adafruit/Adafruit-I2S-Amplifier-BFF-PCB/Adafruit I2S Amplifier BFF.brd

## EAGLE design Adafruit I2S Amplifier BFF.brd (2023-06-14)

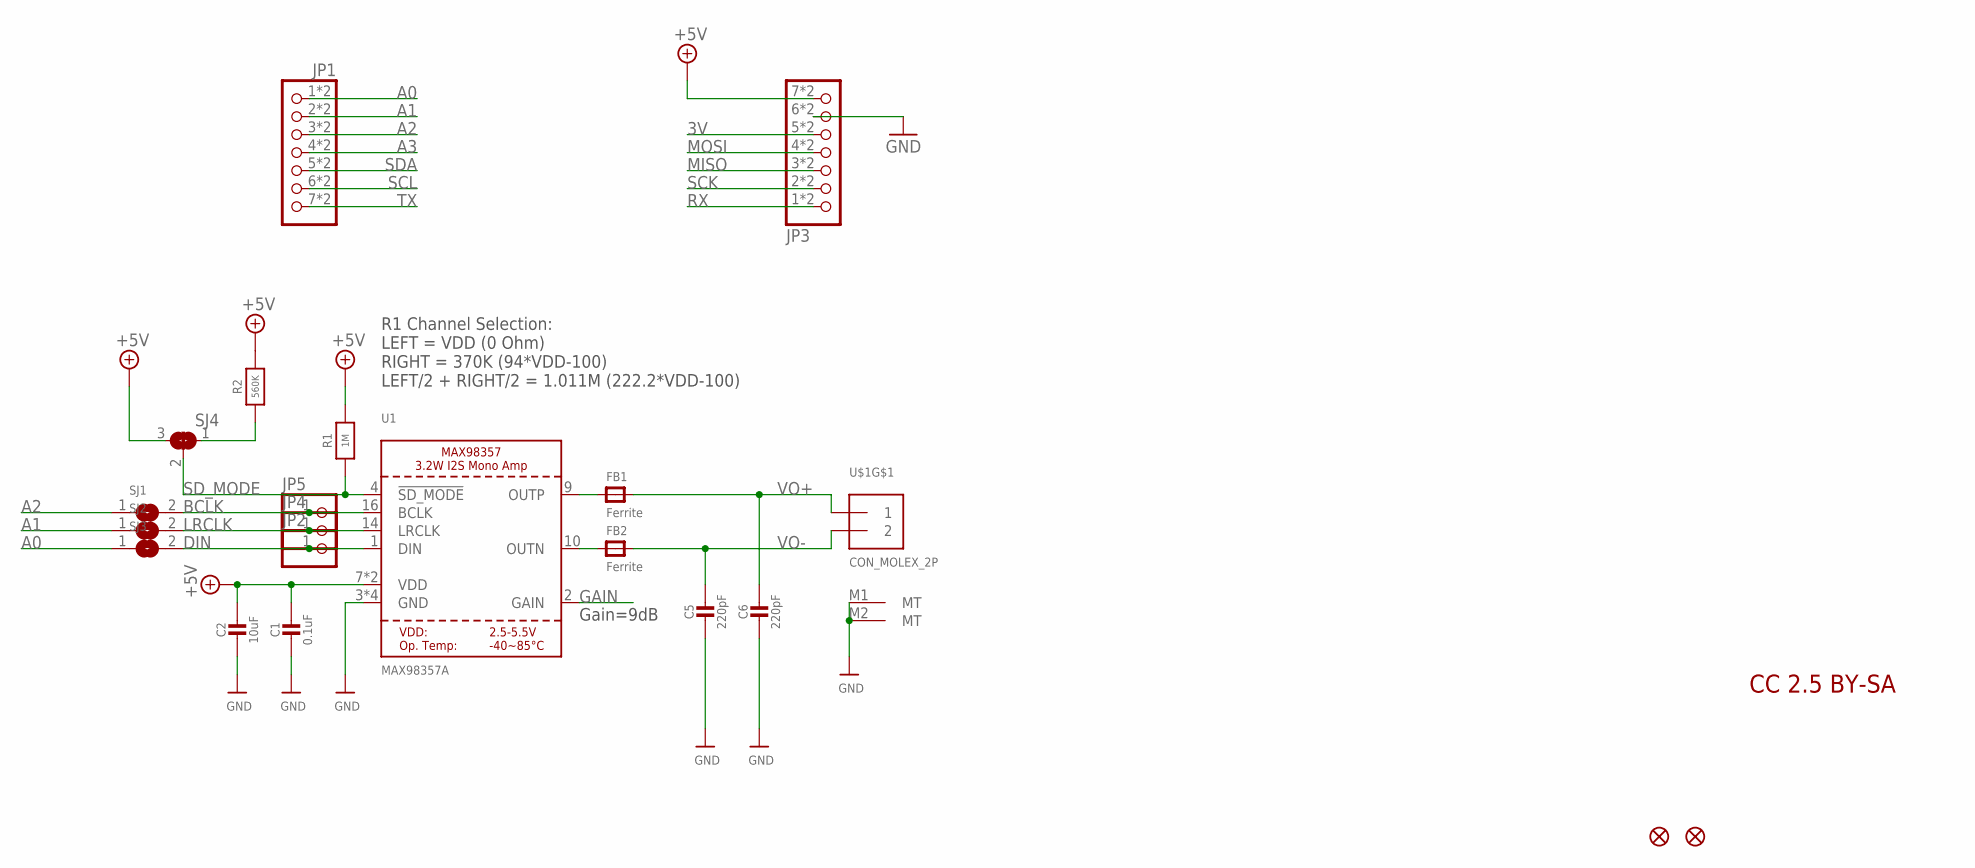
[picture p2: schematic Adafruit I2S Amplifier BFF.sch]

Parts:
C1: 0.1uF; 0603-NO
C2: 10uF; 0805-NO
C5, C6: 220pF; 0603-NO
FB1, FB2: Ferrite; 0603-NO
JP1, JP3: HEADER-1X7_CASTEL; 1X07_CASTEL
JP2, JP4, JP5: HEADER-1X12MM; 1X01_2MM
R1: 1M; 0603-NO
R2: 560K; 0603-NO
SJ1, SJ2, SJ3: SOLDERJUMPERCLOSED; SOLDERJUMPER_CLOSEDWIRE
SJ4: SOLDERJUMPER_2WAY; SOLDERJUMPER_2WAY_OPEN_NOPASTE
U1: MAX98357A; QFN16_3MM
U$1: CON_MOLEX_2P; 53398-0271
U$6, U$8: FIDUCIAL_1MM

Connections:
3V: JP3.5, JP3.5C (5)
+5V: C1.1, C2.1, JP3.7, JP3.7C (7), R1.2, R2.2, SJ4.3, U1.7 (VDD), U1.8 (VDD)
A0: JP1.1, JP1.1C (1), SJ3.1
A1: JP1.2, JP1.2C (2), SJ2.1
A2: JP1.3, JP1.3C (3), SJ1.1
A3: JP1.4, JP1.4C (4)
BCLK: JP5.1, SJ1.2, U1.16 (BCLK)
DIN: JP2.1, SJ3.2, U1.1 (DIN)
GAIN: U1.2 (GAIN)
GND: C1.2, C2.2, C5.2, C6.2, JP3.6, JP3.6C (6), U1.3 (GND), U1.11 (GND), U1.15 (GND), U1.THERMAL (GND), U$1.M1 (MT), U$1.M2 (MT)
LRCLK: JP4.1, SJ2.2, U1.14 (LRCLK)
MISO: JP3.3, JP3.3C (3)
MOSI: JP3.4, JP3.4C (4)
unnamed: R2.1, SJ4.1
unnamed: FB2.1, U1.10 (OUTN)
unnamed: FB1.1, U1.9 (OUTP)
RX: JP3.1, JP3.1C (1)
SCK: JP3.2, JP3.2C (2)
SCL: JP1.6, JP1.6C (6)
SDA: JP1.5, JP1.5C (5)
SD_MODE: R1.1, SJ4.2, U1.4 (!SD_MODE)
TX: JP1.7, JP1.7C (7)
VO+: C6.1, FB1.2, U$1.1
VO-: C5.1, FB2.2, U$1.2

Notes on the sheet:
CC 2.5 BY-SA
R1 Channel Selection: LEFT = VDD (0 Ohm) RIGHT = 370K (94*VDD-100) LEFT/2 + RIGHT/2 = 1.011M (222.2*VDD-100)
Gain=9dB

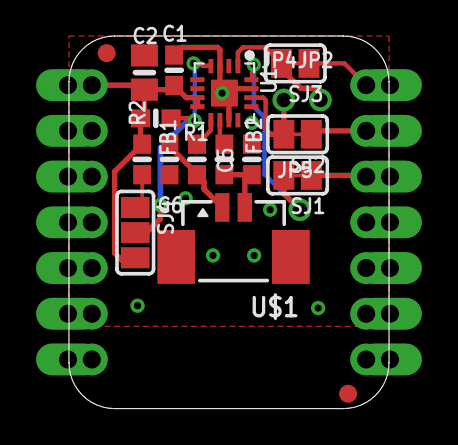
[picture p3: board Adafruit I2S Amplifier BFF.brd from above]

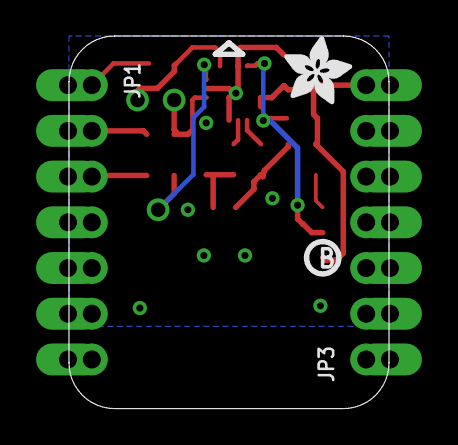
[picture p4: board Adafruit I2S Amplifier BFF.brd from below]

Board: 2 copper layers, 17.8 x 20.7 mm, 43 parts (10 on the bottom side), 23 nets.

Other parts of the board:
PLABEL1: PLABEL1
PLABEL2: PLABEL2
PLABEL3: PLABEL3
PLABEL4: PLABEL4
PLABEL5: PLABEL5
PLABEL6: PLABEL6
PLABEL7: PLABEL7
PLABEL8: PLABEL8
PLABEL12: PLABEL12
PLABEL14: PLABEL14
PLABEL19: PLABEL19
PLABEL20: PLABEL20
PLABEL21: PLABEL21
PLABEL22: PLABEL22
PLABEL23: PLABEL23
PLABEL24: PLABEL24
PLABEL25: PLABEL25
PLABEL26: PLABEL26
PLABEL27: PLABEL27
PLABEL28: PLABEL28
U$2: ADAFRUIT_3.5MM
U$3: PCBFEAT-REV-040
